dfq123456-123/stm32-gamepad/docs/使用手册.md

# 使用手册

## 1. 开机流程

上电后自动执行：

1. USB 初始化（与模式无关，开机即完成枚举）
2. 串口初始化（115200，接蓝牙模块）
3. 延时 800 ms 等 OLED 上电稳定，探测 I2C 地址（兼容 0x78 / 0x7A 两种模块）
4. 开机动画
5. 摇杆中心自动校准
6. 自动进入「测试手柄」界面

按 **HOME** 或 **MENU** 退出测试界面，回到模式首页。

---

## 2. 按键定义

| 键名 | 引脚 | 说明 |
|---|---|---|
| 十字键 上 / 下 / 左 / 右 | PB11 / PB1 / PB10 / PB0 | 走 HID 的 Hat Switch |
| A | PB8 | |
| B | PB7 | |
| X | PB9 | |
| Y | PB6 | |
| LB / RB | PB15 / PB14 | |
| L3 / R3 | PA7 / PA6 | 摇杆下压 |
| HOME | PB3 | 返回 / 退出 |
| MENU | PB4 | 打开或关闭菜单 |
| VIEW | PB5 | 切换游戏模式 ↔ 蓝牙模式 |

三个中间键的语义 **以实测为准**：左键是「返回」不是「切模式」，切模式是上键（VIEW）。

---

## 3. 基本操作

| 操作 | 效果 |
|---|---|
| 按 **MENU** | 打开 / 关闭菜单 |
| 十字键 **上下** | 移动光标（选中项左侧显示 `>`） |
| 十字键 **左右** | 调整当前项参数 |
| 按 **HOME** | 返回上一级 |
| 按 **VIEW** | 在游戏模式与蓝牙模式之间切换 |

---

## 4. 菜单项与参数

### 游戏控制器模式（5 项）

| 项 | 范围 | 步长 | 默认值 | 说明 |
|---|---|---|---|---|
| 死区 | 0 ~ 512 | 10 | 300 | 归一化后偏离中心小于该值视为回中，能盖住采样噪声 |
| 滤波强度 | 0 ~ 8 | 1 | 3 | 一阶低通移位量，越大越稳越钝；0 = 不滤波 |
| 亮度 | 0 ~ 255 | 16 | 255 | OLED 对比度，不是 PWM（OLED 自发光无背光） |
| 关屏 | 关 / 3s / 5s / 10s / 30s | — | 3s | 无操作超时后熄屏省电 |
| 手柄校准 | — | — | — | 左右键进入测试界面，同时重新校准中心 |

### 蓝牙控制器模式（4 项）

| 项 | 范围 | 步长 | 默认值 | 说明 |
|---|---|---|---|---|
| 包头 | 0 ~ 255 | 1 | 0xAA | 帧首字节 |
| 包尾 | 0 ~ 255 | 1 | 0x55 | 帧尾字节 |
| 十六进制 | 关 / 开 | — | 关 | 开则整帧转成 ASCII 十六进制字符发送，方便串口工具查看 |
| 换行 | 关 / 开 | — | 开 | 开则在帧尾追加 `\r\n` |

所有参数改动后约 1 秒写入片内 Flash，掉电不丢。

---

## 5. 测试界面

左右布局对称：顶部是左右扳机进度条，中部是左右摇杆框（中心十字 + 位置圆点）。数值取滤波后的归一化值，与 HID 上报同源，不代表原始 ADC。

进入测试界面时会重新校准中心、重置自适应量程，退出方式：

- 开机自动进的 → 按 HOME/MENU 回模式首页
- 从菜单进的 → 按 HOME/MENU 回菜单列表

---

## 6. USB HID 报告格式（9 字节）

DirectInput 标准格式，15 个按钮 + dpad + 6 轴。

| 字节 | 含义 | 说明 |
|---|---|---|
| 0 | 按键位图 bit0~7 | 见下表 |
| 1 | 按键位图 bit8~10 | |
| 2 | Hat Switch | 0=上 1=上右 2=右 3=右下 4=下 5=下左 6=左 7=左上 8=无 |
| 3 | X | 左摇杆左右，0~255，中心 0x80 |
| 4 | Y | 左摇杆前后，0~255，中心 0x80 |
| 5 | Z | 左扳机 LT，0~255（0 = 松开，255 = 按到底） |
| 6 | Rx | 右摇杆左右，0~255，中心 0x80 |
| 7 | Ry | 右摇杆前后，反向编码 `0x80 - v` |
| 8 | Rz | 右扳机 RT，0~255 |

### 按键位序

| bit | 0 | 1 | 2 | 3 | 4 | 5 | 6 | 7 | 8 | 9 | 10 |
|---|---|---|---|---|---|---|---|---|---|---|---|
| 键 | A | B | X | Y | LB | RB | HOME | MENU | VIEW | L3 | R3 |

十字键不占位图，只走 Hat Switch —— 否则 Steam 绑定时会把「按钮 1（十字键上）」误认成 A。

> 两个扳机是各自独立的轴，可以同时按下。早期 8 字节格式把两扳机编码成一路差动轴，同时按且深度接近时会落到中位被判成"没按"，这是格式固有限制，与硬件无关。

---

## 7. 蓝牙串口帧格式（16 字节）

波特率 115200，8N1。

```
[包头 1B][轴0..轴5 各 2B 小端][按键 2B 小端][包尾 1B]
```

| 段 | 长度 | 内容 |
|---|---|---|
| 包头 | 1 | 默认 0xAA（菜单可改） |
| 轴数据 | 12 | 6 路轴，**原始 ADC 值 0~4095，中心约 2048**，每轴 2 字节小端 |
| 按键位图 | 2 | 小端，bit0=A … bit10=R3；十字键额外回填到 bit11~14（蓝牙帧没有 Hat 字段） |
| 包尾 | 1 | 默认 0x55（菜单可改） |

轴顺序按 ADC 通道序：

| 索引 | 0 | 1 | 2 | 3 | 4 | 5 |
|---|---|---|---|---|---|---|
| 通道 | PA0 (L-VRX) | PA1 (L-VRY) | PA2 (R-VRX) | PA3 (R-VRY) | PA4 (LT) | PA5 (RT) |

开启「十六进制」时整帧变成 32 个 ASCII 字符；开启「换行」时帧尾多 2 字节 `\r\n`。

**注意**：蓝牙帧发的是原始 ADC 通道值，而 USB HID 发的是逻辑轴交叉映射后的值（因为摇杆模块 90° 错位安装，`AXIS_CH_LX = L_VRY`）。两边顺序不同是有意为之，不是 bug。

---

## 8. 常见问题

**PC 认不到手柄**

先看 HSE 是否起振。外部晶振起振失败时芯片会静默降级到内部 HSI 8 MHz，但 `SystemCoreClock` 仍按 72 MHz 计算，导致 USB 时钟只有约 5.3 MHz，USB 彻底不通 —— 而屏幕照常显示，只是慢 9 倍。判据：开机动画超过 7 秒、按键明显迟钝、串口波特率偏掉。

另外，改过报告描述符后 PC 需要重新枚举，Steam 里的按键绑定可能要重设。

**摇杆方向不对（推前却动了 X 轴）**

摇杆模块是 90° 错位安装的，`joystick.h` 里的轴映射做了逻辑交叉。若换成正常朝向的模块，把映射改回直连即可。

**熄屏后屏幕有残影**

增量刷新只在像素变化时重绘，熄屏唤醒时若不全量重画会留下坏像素。唤醒后应调用 `Menu_ForceRedraw()` 强制全量重绘。

**两个扳机不能同时按**

见第 6 节。当前 9 字节 6 轴格式已解决；如果你用的是更早的 8 字节版本，请更新固件。
