dfq123456-123/stm32-gamepad/HARDWARE/delay.c

//delay.c  SysTick 延时

#include "delay.h"

//毫秒延时: 重装载法
void delay_ms(uint32_t ms)
{
	while(ms--)
	{
		SysTick->CTRL=0;					//先关掉才能配寄存器
		SysTick->LOAD=72000-1;				//72MHz/1000=72000, 就是 1ms
		SysTick->VAL=0;						//清当前值, 顺带清计数标志
		SysTick->CTRL=5;					//使能, 时钟源选系统时钟
		while((SysTick->CTRL & (1<<16))==0);//等这次数完
		SysTick->CTRL=0;
	}
}

//微秒延时: 上限 233016us(24bit), 超出钳位
void delay_us(uint32_t us)
{
	if(us==0)return;
	if(us>233016u)us=233016u;

	SysTick->CTRL=0;
	SysTick->LOAD=72*us-1;					//72MHz, us 微秒
	SysTick->VAL=0;
	SysTick->CTRL=5;
	while((SysTick->CTRL & (1<<16))==0);
	SysTick->CTRL=0;
}
