dfq123456-123/stm32-gamepad/HARDWARE/boot_splash_data.c

//boot_splash_data.c - 开机动画数据(自动生成, 勿手改)
//取模: 行优先, MSB在前, 1=点亮
#include "boot_splash.h"

/* 头像 32x32, 每行4字节 */
const uint8_t g_face_bmp[BOOT_FACE_H * ((BOOT_FACE_W + 7) / 8)] =
{
    0x00, 0x1F, 0xF8, 0x00, 0x00, 0x7F, 0xFE, 0x00, 0x01, 0xFF, 0xFF, 0x80,
    0x03, 0xFF, 0xFF, 0xC0, 0x0F, 0xFF, 0xFF, 0xF0, 0x0F, 0x0F, 0xFF, 0xF0,
    0x1C, 0xF3, 0xF0, 0x38, 0x3B, 0xF9, 0xE7, 0xDC, 0x06, 0xFC, 0x0F, 0xEC,
    0x04, 0x7C, 0x1F, 0xF6, 0x0C, 0xFC, 0x1F, 0xF8, 0x0F, 0xFC, 0x1F, 0xF8,
    0x0F, 0xFC, 0x1F, 0xC8, 0x0F, 0xFC, 0x0F, 0x88, 0x07, 0xF8, 0x0F, 0xC8,
    0x03, 0xF0, 0x07, 0xF8, 0x00, 0x00, 0x03, 0xF0, 0x00, 0x0F, 0xF0, 0xE0,
    0xFF, 0xFF, 0xFC, 0x0F, 0xFF, 0xFF, 0xFF, 0xFF, 0xFE, 0x7F, 0xFF, 0xFF,
    0x7D, 0x7F, 0xFF, 0x3E, 0x7D, 0x3F, 0xFF, 0x7E, 0x3D, 0xDF, 0xFF, 0xFC,
    0x3C, 0xCF, 0xFF, 0xFC, 0x1E, 0x13, 0xFF, 0xF8, 0x0F, 0xF8, 0x0F, 0xF0,
    0x0F, 0xFF, 0xFF, 0xF0, 0x03, 0xFF, 0xFF, 0xC0, 0x01, 0xFF, 0xFF, 0x80,
    0x00, 0x4F, 0xFE, 0x00, 0x00, 0x18, 0x38, 0x00
};

/* "肚子隆起来了" 16x16, 6字 x 32字节 */
const uint8_t g_cn_duzi[BOOT_DUZI_NUM * 32] =
{
    0x3E, 0x30, 0x26, 0x30, 0x26, 0x30, 0x26, 0x30, 0x3E, 0xFE, 0x26, 0x30,
    0x26, 0x30, 0x26, 0x30, 0x3E, 0x30, 0x26, 0x30, 0x66, 0x30, 0x46, 0x30,
    0x4D, 0xFE, 0x00, 0x00, 0x00, 0x00, 0x00, 0x00, 0x3F, 0xFC, 0x00, 0x38,
    0x00, 0x60, 0x01, 0x80, 0x01, 0x80, 0x7F, 0xFE, 0x7F, 0xF8, 0x01, 0x80,
    0x01, 0x80, 0x01, 0x80, 0x01, 0x80, 0x01, 0x80, 0x07, 0x00, 0x00, 0x00,
    0x00, 0x00, 0x00, 0x00, 0x00, 0xC0, 0x78, 0xFC, 0x49, 0x88, 0x4B, 0x50,
    0x50, 0x30, 0x53, 0xDE, 0x4B, 0x00, 0x49, 0xFC, 0x4D, 0x20, 0x4F, 0xFC,
    0x5A, 0x20, 0x41, 0xFC, 0x40, 0x20, 0x43, 0xFE, 0x00, 0x00, 0x00, 0x00,
    0x08, 0x00, 0x08, 0xFC, 0x3E, 0x04, 0x08, 0x04, 0x08, 0x04, 0x08, 0x7C,
    0x7F, 0x7C, 0x0C, 0x40, 0x3C, 0x40, 0x2F, 0x46, 0x2C, 0x46, 0x3C, 0x7C,
    0x4C, 0x00, 0x47, 0xFE, 0x00, 0x00, 0x00, 0x00, 0x01, 0x80, 0x01, 0x80,
    0x3F, 0xFC, 0x01, 0x80, 0x09, 0x90, 0x0D, 0xB0, 0x01, 0xA0, 0x7F, 0xFE,
    0x03, 0xC0, 0x05, 0xE0, 0x0D, 0xB0, 0x39, 0x9C, 0x61, 0x86, 0x01, 0x80,
    0x00, 0x00, 0x00, 0x00, 0x3F, 0xFC, 0x00, 0x1C, 0x00, 0x30, 0x00, 0xE0,
    0x01, 0x80, 0x01, 0x80, 0x01, 0x80, 0x01, 0x80, 0x01, 0x80, 0x01, 0x80,
    0x01, 0x80, 0x01, 0x80, 0x07, 0x80, 0x00, 0x00, 0x00, 0x00, 0x00, 0x00
};

/* "达芬奇w" 14x14, 4字 x 28字节 */
const uint8_t g_cn_dfq[BOOT_DFQ_NUM * 28] =
{
    0x00, 0x00, 0x08, 0x20, 0x0C, 0x20, 0x04, 0x20, 0x01, 0xFE, 0x18, 0x20,
    0x0C, 0x20, 0x04, 0x58, 0x04, 0x48, 0x04, 0x84, 0x0D, 0x02, 0x1E, 0x00,
    0x11, 0xFE, 0x00, 0x00, 0x00, 0x00, 0x02, 0x10, 0x1F, 0xFE, 0x03, 0x30,
    0x00, 0x20, 0x03, 0x30, 0x06, 0x18, 0x0C, 0x0E, 0x13, 0xF2, 0x01, 0x10,
    0x02, 0x10, 0x06, 0x10, 0x0C, 0x70, 0x00, 0x00, 0x00, 0x00, 0x00, 0x80,
    0x1F, 0xFE, 0x01, 0xC0, 0x07, 0x3C, 0x0C, 0x00, 0x1F, 0xFE, 0x00, 0x08,
    0x07, 0xC8, 0x04, 0x48, 0x07, 0xC8, 0x04, 0x48, 0x00, 0x18, 0x00, 0x00,
    0x00, 0x00, 0x00, 0x00, 0x00, 0x00, 0x00, 0x00, 0x04, 0xB0, 0x07, 0xA0,
    0x03, 0x60, 0x03, 0x60, 0x03, 0x60, 0x02, 0x40, 0x00, 0x00, 0x00, 0x00,
    0x00, 0x00, 0x00, 0x00
};
