dfq123456-123/stm32-gamepad/HARDWARE/boot_splash.h

//boot_splash.h - 开机动画(头像 + "肚子隆起来了" + 名字水印)
//数据见 boot_splash_data.c:
#ifndef __BOOT_SPLASH_H
#define __BOOT_SPLASH_H

#include "stm32f10x.h"

#define BOOT_FACE_W    32
#define BOOT_FACE_H    32
#define BOOT_DUZI_NUM  6	//"肚子隆起来了"
#define BOOT_DFQ_NUM   4	//"达芬奇w"

	//开机动画: 画完停留后清屏(校准界面会接着覆盖)
void Boot_Splash(void);

#endif	//__BOOT_SPLASH_H
