dfq123456-123/stm32-gamepad/(commit log)

2026-09-07 初始化提交: STM32F103C8T6 双模游戏手柄固件(USB HID + 蓝牙串口)
2026-09-07 修 .gitignore
2026-09-07 fix(joystick): 修复相邻 ADC 通道串扰导致的摇杆互拖 + 自适应滤波降延迟
2026-09-07 flash_save 先存个进度, 还有6个编译错误没修
2026-09-08 串扰再压一版, 修熄屏唤醒残影
2026-09-08 ADC过采样取均值, 串扰基本根治
2026-09-08 合并另一份代码的加固修复
2026-09-15 菜单中文化, 修字模
2026-09-15 删掉ppt
2026-09-15 清理非工程文件, 只留纯净工程
2026-09-16 HID改成9字节6轴, 两个扳机分开能同时按
2026-10-21 优化代码结构
2026-10-21 加README和使用手册
2026-10-21 清理代码, 去掉没用到的 WS2812
2026-10-21 outputs 加进 gitignore
